Lucas-Luwa/steno-keyboard/V3/images/earlier-cover-fit-poster.jpg

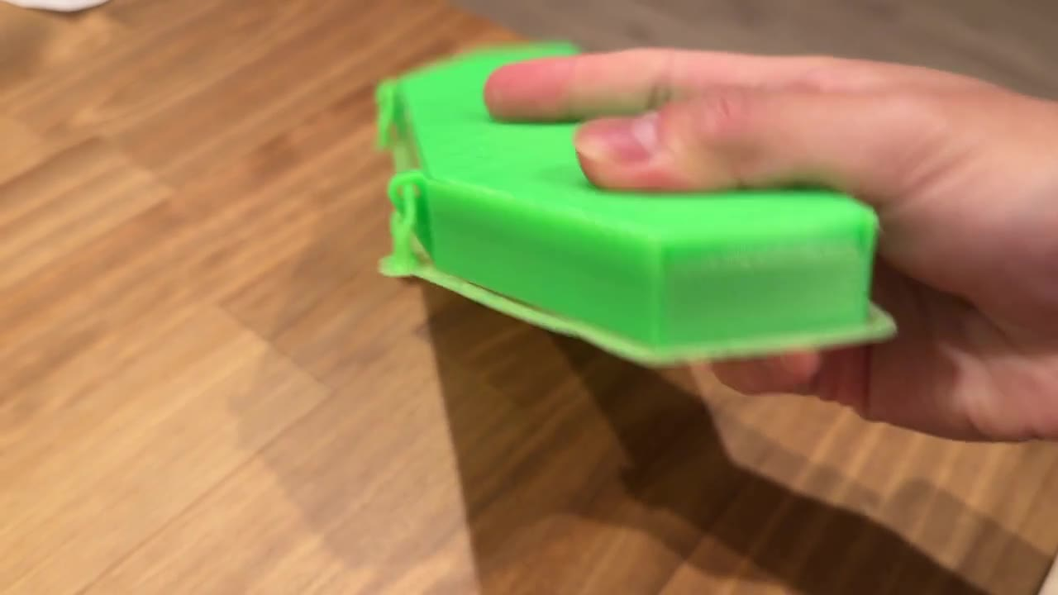
V3/images/earlier-cover-fit-poster.jpg
