Lucas-Luwa/steno-keyboard/V3/images/led-diagnostic-chase-poster.jpg

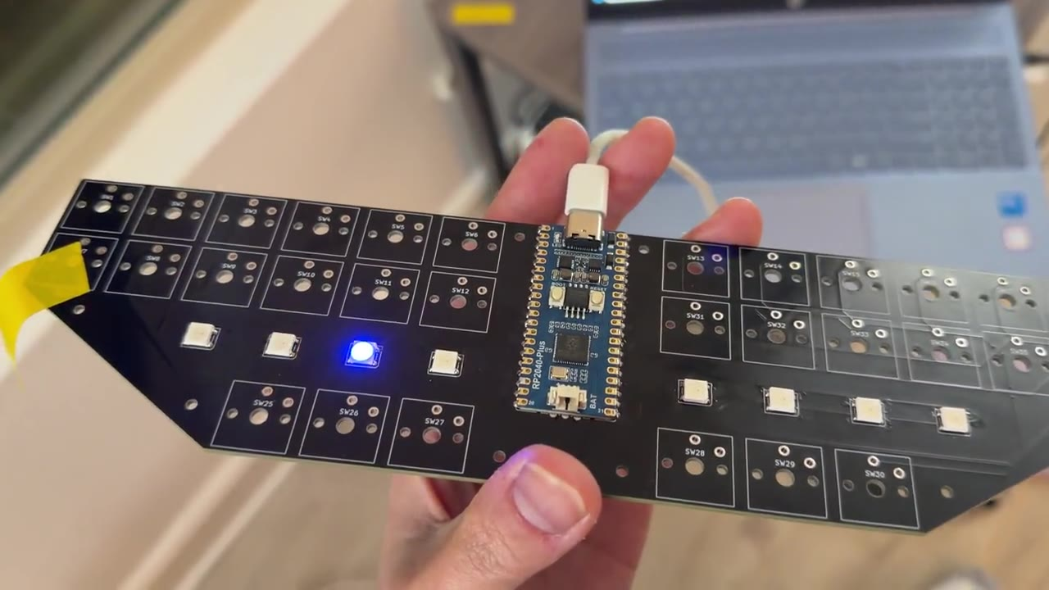
V3/images/led-diagnostic-chase-poster.jpg
