Lucas-Luwa/steno-keyboard/V3/images/lighting-idle-and-key-activity-poster.jpg

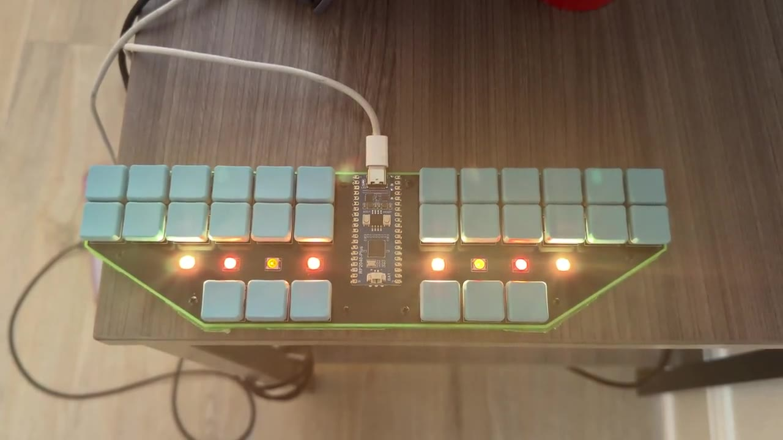
V3/images/lighting-idle-and-key-activity-poster.jpg
