Lucas-Luwa/steno-keyboard/V3/images/onboard-lighting-demo-poster.jpg

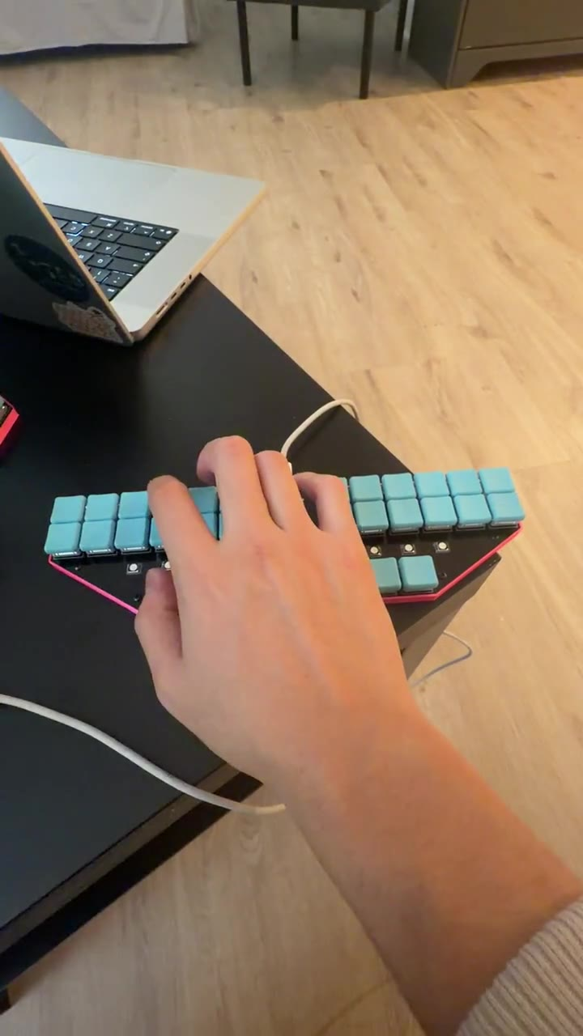
V3/images/onboard-lighting-demo-poster.jpg
