Lucas-Luwa/steno-keyboard/V3/images/pcb-back.png

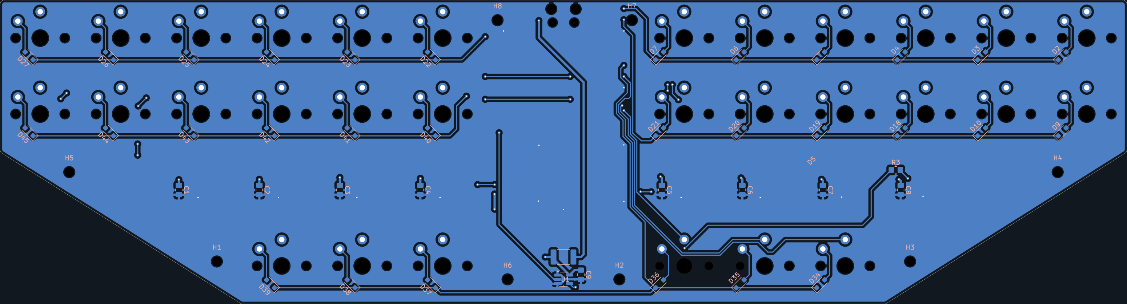
V3/images/pcb-back.png
