Lucas-Luwa/steno-keyboard/V3/hardware/bom.csv

quantity | references | value | footprint | notes
9 | C1 C2 C3 C4 C5 C6 C7 C8 C9 | 100n | Capacitor_SMD:C_0805_2012Metric_Pad1.18x1.45mm_HandSolder | 100 nF capacitor; 0805.
30 | D2 D3 D4 D5 D6 D7 D9 D10 D18 D19 D20 D21 D22 D23 D24 D25 D26 D27 D34 D35 D36 D37 D38 D39 D40 D41 D42 D43 D44 D45 | 1N4148W | Diode_SMD:D_SOD-323_HandSoldering | 1N4148-family diode in SOD-323 (e.g. 1N4148WS); band marks cathode.
1 | R3 | 330R | Resistor_SMD:R_0805_2012Metric_Pad1.20x1.40mm_HandSolder | 330 ohm LED data resistor; 0805.
1 | U1 | 74AHCT1G125 | Package_TO_SOT_SMD:SOT-23-5_HandSoldering | SOT-23-5 buffer; 74AHCT1G125 or SN74LV1T34DBVR. Pin connections: hardware guide.
1 | F1 | MF_MSMF050-2 | Fuse:Fuse_1812_4532Metric_Pad1.30x3.40mm_HandSolder | Resettable fuse; 1812.
8 | H1 H2 H3 H4 H5 H6 H7 H8 | MountingHole | MountingHole:MountingHole_2.2mm_M2 | 2.2 mm PCB clearance hole for M2 screw.
1 | A1 | RaspberryPi_Pico | Module:RaspberryPi_Pico_SMD_HandSolder | Waveshare RP2040-Plus-16MB; Pico-compatible castellated footprint.
30 | SW1 SW2 SW3 SW4 SW5 SW6 SW7 SW8 SW9 SW10 SW11 SW12 SW13 SW14 SW15 SW16 SW17 SW18 SW25 SW26 SW27 SW28 SW29 SW30 SW31 SW32 SW33 SW34 SW35 SW36 | SW_Push | Switch_Keyboard_Kailh:SW_Kailh_Choc_V1_1.00u | Kailh Choc V1 switch.
8 | LED8 LED12 LED13 LED14 LED15 LED16 LED17 LED28 | WS2812C | LED_SMD:LED_WS2812B_PLCC4_5.0x5.0mm_P3.2mm | WS2812B RGB LED; 5 x 5 mm four-pin footprint. WS2812C is the schematic value label.
