Lucas-Luwa/steno-keyboard/V3/mechanical/step/pcb-assembly.step

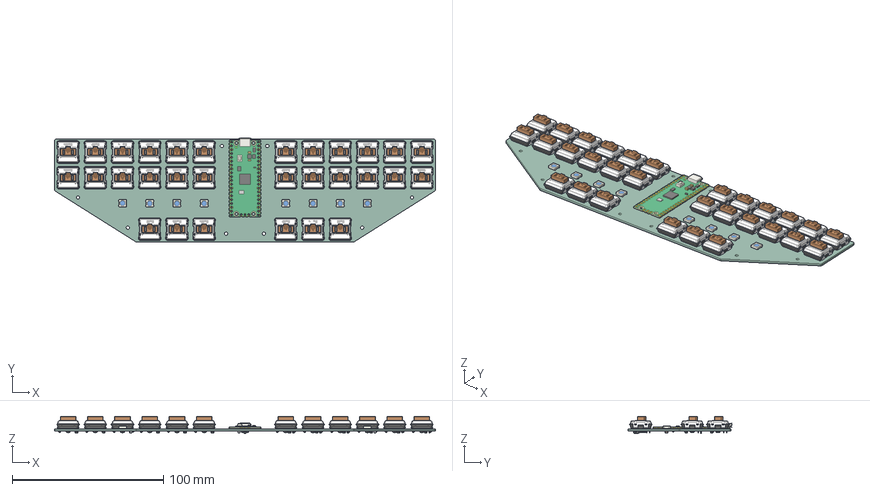
[picture p17: CAD file, 2026-10-21]
V3/mechanical/step/pcb-assembly.step
252.0 x 68.8 x 11.3 mm
LED_WS2812B_PLCC4_50x50mm_P32mm x 8
SW_Kailh_Choc_V1_cp x 30
RaspberryPi_Pico_Module_KiCad
terminals
C_0805_2012Metric x 9
D_SOD-323 x 30
SOT-23-5
R_0805_2012Metric
SteE9F_PCB
