Lucas-Luwa/steno-keyboard/V3/mechanical/solidworks/StenoFullASMV1SINGLEPART.SLDPRT

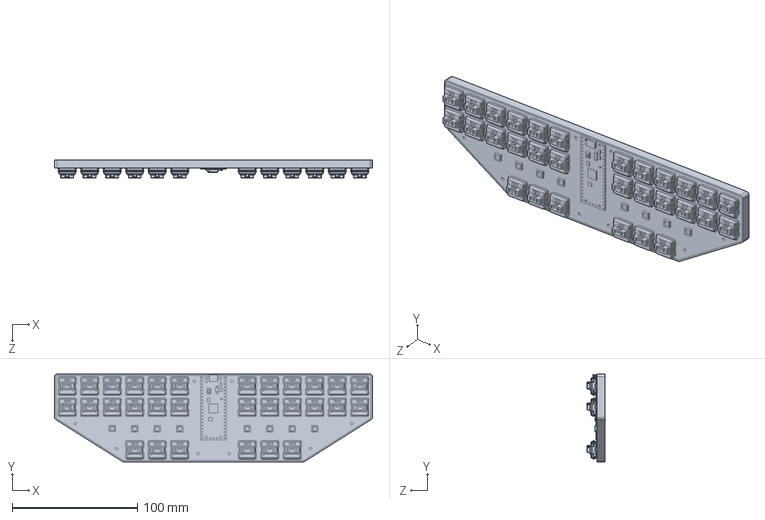
[picture p18: CAD file, 2026-10-21]
V3/mechanical/solidworks/StenoFullASMV1SINGLEPART.SLDPRT
254.3 x 70.3 x 14.3 mm
