Lucas-Luwa/steno-keyboard/V3/hardware/models/SW_Kailh_Choc_V1.stp

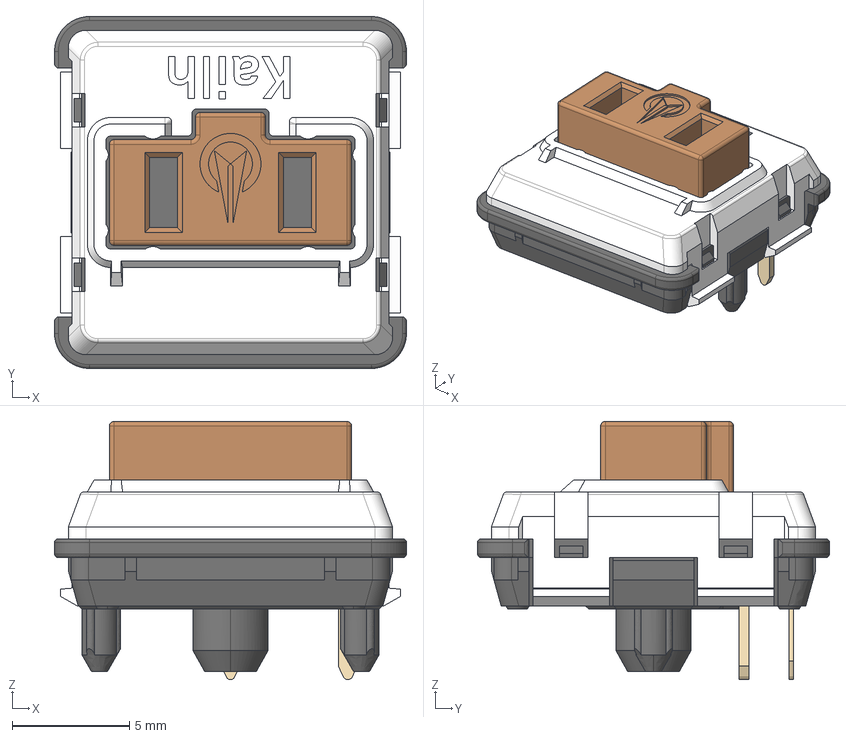
[picture p19: CAD file, 2026-10-21]
V3/hardware/models/SW_Kailh_Choc_V1.stp
15.0 x 15.0 x 11.0 mm
