Lucas-Luwa/steno-keyboard/V3/mechanical/step/travel-cap.step

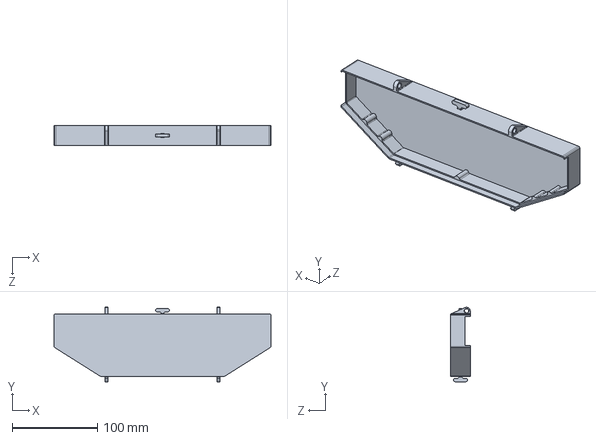
[picture p20: CAD file, 2026-10-28]
V3/mechanical/step/travel-cap.step
254.3 x 87.4 x 23.0 mm
