Lucas-Luwa/steno-keyboard/V3/mechanical/stl/case-bottom.stl

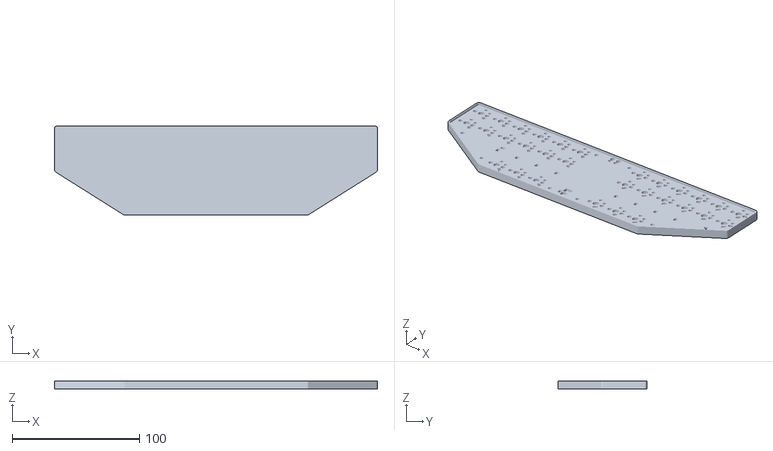
[picture p21: CAD file, 2026-10-21]
V3/mechanical/stl/case-bottom.stl
254.3 x 70.3 x 6.34
