Lucas-Luwa/steno-keyboard/V3/hardware/models/mf-msmf050-2.step

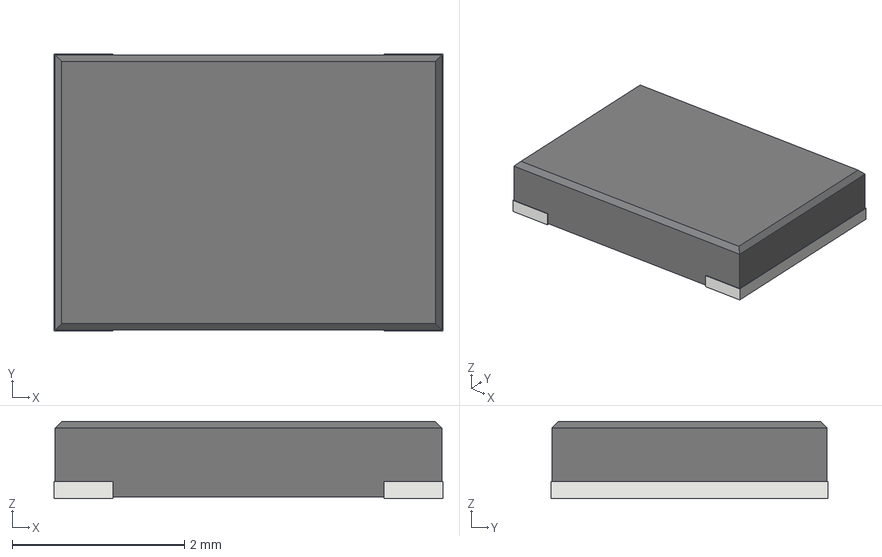
[picture p22: CAD file, 2026-10-13]
V3/hardware/models/mf-msmf050-2.step
4.52 x 3.22 x 0.9 mm
terminals
