Lucas-Luwa/steno-keyboard/V3/mechanical/solidworks/LEDAlignmentJigShort.SLDPRT

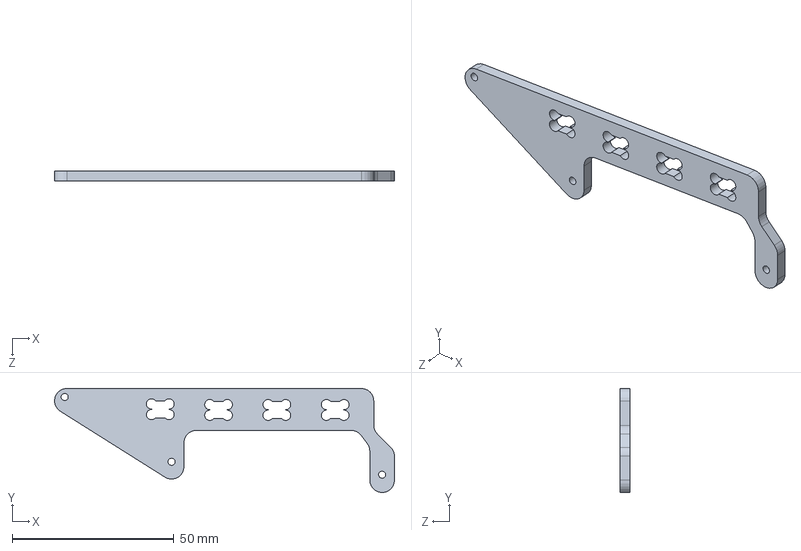
[picture p23: CAD file, 2026-10-26]
V3/mechanical/solidworks/LEDAlignmentJigShort.SLDPRT
105.0 x 32.1 x 3.17 mm
