Lucas-Luwa/steno-keyboard/V3/mechanical/stl/insert-test-coupon.stl

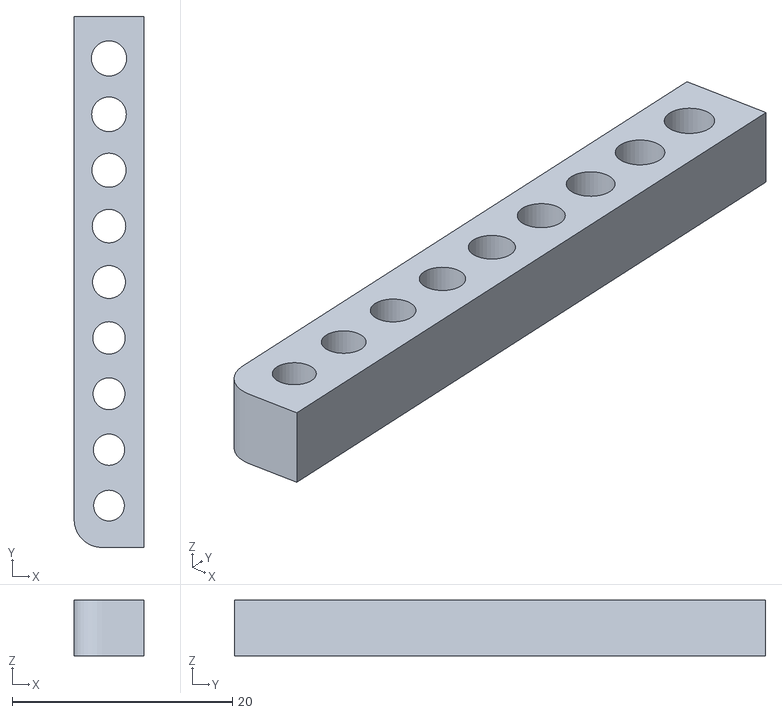
[picture p24: CAD file, 2026-10-21]
V3/mechanical/stl/insert-test-coupon.stl
6.35 x 48.3 x 5.08
