Lucas-Luwa/steno-keyboard/V3/mechanical/step/Choc_Stem_Choc_Size_Normal.step

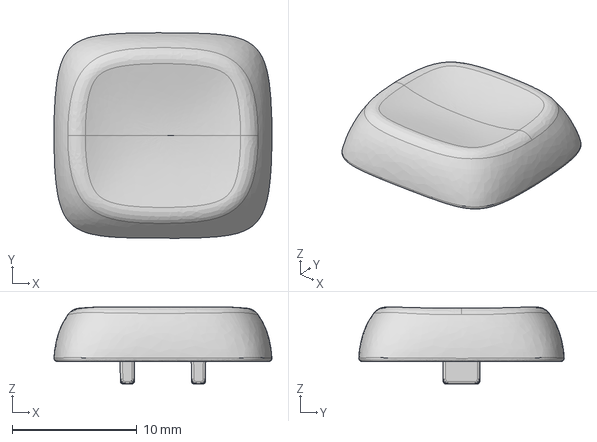
[picture p25: CAD file, 2026-10-21]
V3/mechanical/step/Choc_Stem_Choc_Size_Normal.step
17.5 x 16.5 x 6.17 mm
