Lucas-Luwa/steno-keyboard/V3/mechanical/solidworks/ChocKeyCap.SLDPRT

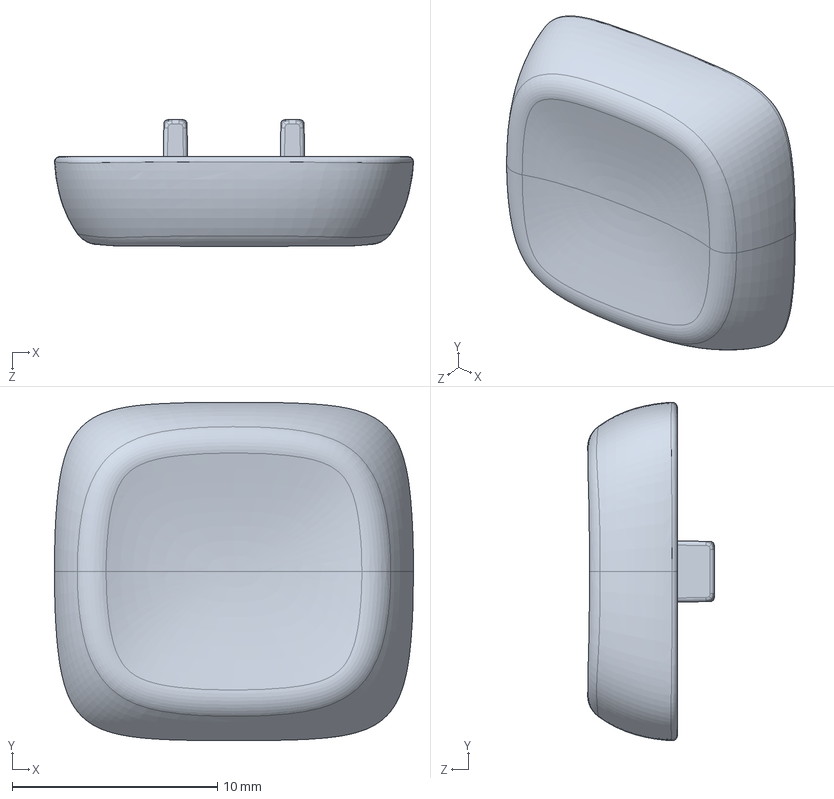
[picture p26: CAD file, 2026-10-21]
V3/mechanical/solidworks/ChocKeyCap.SLDPRT
17.5 x 16.5 x 6.17 mm
