Lucas-Luwa/steno-keyboard/V3/mechanical/solidworks/StenoFullASMV1.SLDASM

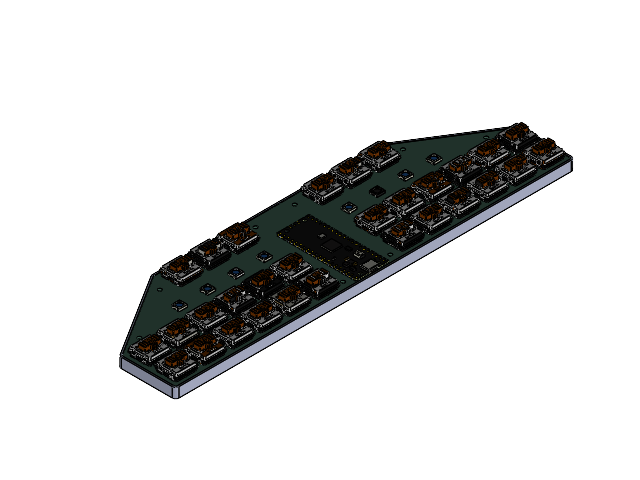
[picture p27: CAD file, 2026-10-21]
V3/mechanical/solidworks/StenoFullASMV1.SLDASM
BottomCasePARTONLYV1
StenoV5
