Lucas-Luwa/steno-keyboard/(list of files, cad)

Other CAD files:
V3/mechanical/solidworks/mf-msmf050-2_1.step.SLDASM
V3/mechanical/solidworks/LED_WS2812B_PLCC4_5.0x5.0mm_P3.2mm_1.step.SLDASM
V3/mechanical/solidworks/SW_Kailh_Choc_V1-1_1.step.SLDASM
V3/mechanical/solidworks/D_SOD-323_1.step.SLDASM
V3/mechanical/solidworks/C_0805_2012Metric_1.step.SLDASM
V3/mechanical/solidworks/SW_Kailh_Choc_V1_1.step.SLDASM
V3/mechanical/solidworks/Fuse_1812_4532Metric_1.step.SLDASM
V3/mechanical/solidworks/RaspberryPi_Pico_KiCad_1.step.SLDASM
V3/mechanical/solidworks/RaspberryPi_Pico_1.step.SLDASM
V3/mechanical/solidworks/SOT-23-5_1.step.SLDASM
V3/mechanical/solidworks/R_0805_2012Metric_1.step.SLDASM
V3/mechanical/print-jobs/A1/insert-test-coupon.gcode.3mf
V3/mechanical/print-jobs/P1S/insert-test-coupon.gcode.3mf
V3/mechanical/print-jobs/P2S/insert-test-coupon.gcode.3mf
V3/mechanical/solidworks/LEDAlignmentJig.SLDPRT
V3/mechanical/print-jobs/A1/travel-cap.gcode.3mf
V3/mechanical/print-jobs/P1S/case-bottom.gcode.3mf
V3/mechanical/print-jobs/P2S/travel-cap.gcode.3mf
V3/mechanical/print-jobs/A1/case-bottom.gcode.3mf
V3/mechanical/print-jobs/P1S/travel-cap.gcode.3mf
V3/mechanical/print-jobs/P2S/case-bottom.gcode.3mf
V3/mechanical/solidworks/BottomCasePARTONLYV1.SLDPRT
V3/mechanical/solidworks/body_1.step.SLDPRT
V3/mechanical/solidworks/StenoV5.SLDPRT
V3/mechanical/solidworks/TopCaseV3.SLDPRT
V3/mechanical/solidworks/SW_Kailh_Choc_V1_cp_1.step.SLDPRT
V3/mechanical/solidworks/R_0805_2012Metric-4_1.step.SLDPRT
V3/mechanical/solidworks/Ste5C4A_PCB_1.step.SLDPRT
V3/mechanical/solidworks/SOT-23-5-0_1.step.SLDPRT
V3/mechanical/solidworks/TestPrintHoles.SLDPRT
V3/mechanical/solidworks/terminals_1.step.SLDPRT
V3/mechanical/solidworks/LED_WS2812B_PLCC4_50x50mm_P32mm_1.step.SLDPRT
V3/mechanical/solidworks/C_0805_2012Metric-2_1.step.SLDPRT
V3/mechanical/solidworks/Bottom Prototype.SLDPRT
V3/mechanical/solidworks/SW_Kailh_Choc_V1_cp-1_1.step.SLDPRT
V3/mechanical/solidworks/RaspberryPi_Pico_Module_KiCad_1.step.SLDPRT
V3/mechanical/solidworks/D_SOD-323-3_1.step.SLDPRT
V3/mechanical/solidworks/TopCaseV1.SLDPRT
V3/mechanical/solidworks/TopCaseV2.SLDPRT
V3/mechanical/solidworks/travel-cap.SLDPRT
V3/mechanical/stl/led-alignment-jig-short.stl
V3/mechanical/stl/led-alignment-jig.stl
V3/mechanical/stl/travel-cap.stl
archive/prints/BottomCasePARTONLYV1.STL
archive/prints/BottomSTLV1.STL
archive/prints/BottomSTLV2.STL
archive/prints/travel-cap-previous-A1.gcode.3mf
archive/prints/travel-cap-previous-P1S.gcode.3mf
archive/prints/travel-cap-previous-P2S.gcode.3mf
archive/prints/travel-cap-previous.stl
