Lucas-Luwa/steno-keyboard/V3/firmware/led-tests/energy-catalog.md

# Fast/fade extension: 35 cues

Use the IDs with `run.py --pattern ID`; add `--energy` for extension cues.

| Section | ID | Description | Seconds |
| --- | --- | --- | ---: |
| energy | `energy-fade-slow` | Smooth fade in/out: zero to selected peak | 8 |
| energy | `energy-fade-fast` | Fast fade in/out: two pulses per second | 6 |
| energy | `energy-attack-decay` | Sharp attack with a fading tail | 6 |
| energy | `energy-crossfade` | Left and right crossfade | 6 |
| energy | `energy-colour-fade` | Rapid smooth saturated color fades | 6 |
| energy | `energy-out-12` | 4+5, 3+6, 2+7, 1+8: 12 pair steps/sec | 6 |
| energy | `energy-out-24` | 4+5, 3+6, 2+7, 1+8: 24 pair steps/sec | 6 |
| energy | `energy-out-40` | 4+5, 3+6, 2+7, 1+8: 40 pair steps/sec | 6 |
| energy | `energy-in` | Outside-in pairs: 24 steps/sec | 6 |
| energy | `energy-pingpong` | Center-out then edge-in: 24 steps/sec | 6 |
| energy | `energy-fill` | Pairs rapidly fill out from the center | 6 |
| energy | `energy-stripe-trails` | Center-out pairs with fading trails | 6 |
| energy | `energy-stripe-rainbow` | Center-out pairs cycle saturated hues | 6 |
| energy | `energy-stripe-random` | Center-out pairs change to a random color each sweep | 6 |
| energy | `energy-chase-16` | Fast chase: 16 LED positions/sec | 6 |
| energy | `energy-chase-32` | Fast chase: 32 LED positions/sec | 6 |
| energy | `energy-chase-64` | Fast chase: 64 LED positions/sec | 6 |
| energy | `energy-scanner` | Fast bouncing scanner: 40 positions/sec | 6 |
| energy | `energy-comets` | Opposing colored comets: 32 positions/sec | 6 |
| energy | `energy-opposed` | Opposing dots: 32 positions/sec | 6 |
| energy | `energy-colour-12` | Whole row switches random colors 12 times/sec | 6 |
| energy | `energy-colour-24` | Whole row switches random colors 24 times/sec | 6 |
| energy | `energy-random-pixels` | All pixels change independently 24 times/sec | 6 |
| energy | `energy-bursts` | Random colored spatial bursts 16 times/sec | 6 |
| energy | `energy-sparkles` | Rapid isolated colored sparks: 40 updates/sec | 6 |
| energy | `energy-alternate` | Rapid left/right color alternation | 6 |
| energy | `energy-180` | 180 BPM sixteenth-note motion | 6 |
| energy | `energy-220` | 220 BPM sixteenth-note motion | 6 |
| energy | `energy-triplets` | 200 BPM triplet motion | 6 |
| energy | `energy-build-drop` | Accelerating stripes, dark gap, then colored bursts | 8 |
| energy | `energy-strobe-8` | Magenta flashes: 8 Hz | 6 |
| energy | `energy-strobe-12` | Magenta flashes: 12 Hz | 6 |
| energy | `energy-strobe-16` | Magenta flashes: 16 Hz | 6 |
| energy | `energy-burst-strobe` | Random-color double/triple flash bursts | 6 |
| energy | `energy-mix` | Rapid pattern switching: stripes/chase/bursts/sparkles | 8 |
