Lucas-Luwa/steno-keyboard/V3/firmware/led-tests/catalogue.md

# Base showcase: 134 cues

Use the IDs with `run.py --pattern ID`; add `--energy` for extension cues.

| Section | ID | Description | Seconds |
| --- | --- | --- | ---: |
| mapping | `map-01` | Position 1: LED17 | 2 |
| mapping | `map-02` | Position 2: LED16 | 2 |
| mapping | `map-03` | Position 3: LED15 | 2 |
| mapping | `map-04` | Position 4: LED14 | 2 |
| mapping | `map-05` | Position 5: LED13 | 2 |
| mapping | `map-06` | Position 6: LED12 | 2 |
| mapping | `map-07` | Position 7: LED8 | 2 |
| mapping | `map-08` | Position 8: LED28 | 2 |
| mapping | `map-left` | Four left LEDs only | 3 |
| mapping | `map-right` | Four right LEDs only | 3 |
| colors | `color-red` | red | 3 |
| colors | `color-green` | green | 3 |
| colors | `color-blue` | blue | 3 |
| colors | `color-yellow` | yellow | 3 |
| colors | `color-cyan` | cyan | 3 |
| colors | `color-magenta` | magenta | 3 |
| colors | `color-orange` | orange | 3 |
| colors | `color-amber` | amber | 3 |
| colors | `color-lime` | lime | 3 |
| colors | `color-emerald` | emerald | 3 |
| colors | `color-teal` | teal | 3 |
| colors | `color-sky-blue` | sky blue | 3 |
| colors | `color-royal-blue` | royal blue | 3 |
| colors | `color-violet` | violet | 3 |
| colors | `color-purple` | purple | 3 |
| colors | `color-hot-pink` | hot pink | 3 |
| colors | `color-rose` | rose | 3 |
| colors | `color-coral` | coral | 3 |
| colors | `color-lavender` | lavender | 3 |
| colors | `color-pastel-pink` | pastel pink | 3 |
| colors | `color-ice-blue` | ice blue | 3 |
| colors | `color-warm-purple` | warm purple | 3 |
| brightness | `steps-red` | Raw brightness steps: red | 22.5 |
| brightness | `steps-green` | Raw brightness steps: green | 22.5 |
| brightness | `steps-blue` | Raw brightness steps: blue | 22.5 |
| brightness | `steps-magenta` | Raw brightness steps: magenta | 22.5 |
| brightness | `steps-cyan` | Raw brightness steps: cyan | 22.5 |
| brightness | `steps-orange` | Raw brightness steps: orange | 22.5 |
| brightness | `steps-lavender` | Raw brightness steps: lavender | 22.5 |
| brightness | `compare-16-32` | Magenta A/B: 16 versus 32 | 8 |
| brightness | `compare-16-64` | Magenta A/B: 16 versus 64 | 8 |
| brightness | `compare-16-128` | Magenta A/B: 16 versus 128 | 8 |
| brightness | `compare-16-255` | Magenta A/B: 16 versus 255 | 8 |
| brightness | `compare-64-128` | Magenta A/B: 64 versus 128 | 8 |
| brightness | `compare-128-255` | Magenta A/B: 128 versus 255 | 8 |
| brightness | `ramp-red` | Continuous raw ramp: red | 8 |
| brightness | `gamma-red` | Perceptual-style ramp: red | 8 |
| brightness | `ramp-magenta` | Continuous raw ramp: magenta | 8 |
| brightness | `gamma-magenta` | Perceptual-style ramp: magenta | 8 |
| brightness | `ramp-lavender` | Continuous raw ramp: lavender | 8 |
| brightness | `gamma-lavender` | Perceptual-style ramp: lavender | 8 |
| brightness | `density-one` | One LED versus eight at the same channel level | 8 |
| motion | `chase-red` | One red dot, left to right | 7 |
| motion | `chase-blue-back` | One blue dot, right to left | 7 |
| motion | `chase-rainbow` | One dot changes hue as it moves | 7 |
| motion | `chase-pair` | Two adjacent moving dots | 7 |
| motion | `chase-opposed` | Two dots move in opposite directions | 7 |
| motion | `bounce` | Single dot bounces at the ends | 7 |
| motion | `scanner` | Scanner with a soft trail | 7 |
| motion | `comet-short` | Short comet tail | 7 |
| motion | `comet-long` | Long comet tail | 7 |
| motion | `chase-fast` | Fast single-dot chase | 7 |
| motion | `chase-slow` | Slow single-dot chase | 7 |
| motion | `fill-drain` | Fill then drain the row | 8 |
| motion | `color-wipe` | Colour wipe across all eight | 8 |
| motion | `rainbow-conveyor` | Moving saturated rainbow | 8 |
| motion | `gradient-conveyor` | Moving purple/cyan gradient | 8 |
| motion | `sine-wave` | Smooth wave of brightness | 8 |
| motion | `two-waves` | Two overlapping coloured waves | 8 |
| motion | `bouncing-particle` | Smooth bouncing point with subpixel blending | 8 |
| motion | `random-walk` | A dot wanders between neighbours | 8 |
| motion | `binary` | Slow binary count in magenta | 8 |
| symmetry | `mirror-out` | Mirrored centre-to-edge dots | 8 |
| symmetry | `mirror-in` | Mirrored edge-to-centre dots | 8 |
| symmetry | `mirror-comet` | Mirrored centre-out comet trails | 8 |
| symmetry | `mirror-fill` | Both halves fill out from the centre | 8 |
| symmetry | `mirror-breathe` | Both halves breathe together | 8 |
| symmetry | `cross-breathe` | Left and right take turns breathing | 8 |
| symmetry | `alternate-banks` | Left/right colour alternation | 8 |
| symmetry | `split-colors` | Purple left / cyan right | 8 |
| symmetry | `checkerboard` | Alternating individual LEDs | 8 |
| symmetry | `paired-zones` | Four two-LED zones | 8 |
| symmetry | `centre-glow` | Centre glows with a soft falloff | 8 |
| symmetry | `edges-glow` | Outer edges glow with a soft falloff | 8 |
| textures | `breathe-purple` | Slow purple breathing | 10 |
| textures | `breathe-blue` | Slow blue breathing | 10 |
| textures | `hue-fade` | All LEDs fade through saturated hues | 10 |
| textures | `palette-neon` | Neon palette transitions | 10 |
| textures | `palette-ocean` | Ocean palette transitions | 10 |
| textures | `fire` | Warm flickering embers | 10 |
| textures | `ocean-shimmer` | Blue/teal shimmer | 10 |
| textures | `aurora` | Slow purple/green aurora | 10 |
| textures | `sparkle-sparse` | Sparse coloured sparkles | 10 |
| textures | `sparkle-dense` | Dense coloured sparkles | 10 |
| textures | `twinkle` | Soft independent twinkles | 10 |
| textures | `raindrops` | Drops appear and fade away | 10 |
| textures | `random-colors` | Random saturated colour per LED | 10 |
| textures | `noise-flow` | Flowing multicolour texture | 10 |
| beats | `beat-pulse-60` | Synthetic beat pulse: 60 BPM | 8 |
| beats | `beat-pulse-90` | Synthetic beat pulse: 90 BPM | 8 |
| beats | `beat-pulse-120` | Synthetic beat pulse: 120 BPM | 8 |
| beats | `beat-pulse-150` | Synthetic beat pulse: 150 BPM | 8 |
| beats | `beat-pulse-180` | Synthetic beat pulse: 180 BPM | 8 |
| beats | `beat-alternate` | Alternate halves on each beat | 12 |
| beats | `beat-color` | Choose a saturated colour on each beat | 12 |
| beats | `beat-step` | Advance one LED per beat | 12 |
| beats | `beat-mirror` | Launch a mirrored wave on each beat | 12 |
| beats | `beat-burst` | Random spatial burst on each beat | 12 |
| beats | `beat-kick` | Bass/kick: strong pulse with decay | 12 |
| beats | `beat-snare` | Snare/backbeat: alternate accented beats | 12 |
| beats | `beat-hats` | Hi-hat-style eighth-note sparkles | 12 |
| beats | `beat-layered` | Synthetic kick, snare and hats together | 12 |
| beats | `beat-subdivide` | Quarter/eighth/sixteenth-note motion | 12 |
| beats | `beat-half-double` | Half-time then double-time feel | 12 |
| beats | `beat-swing` | Swinging pairs of light pulses | 12 |
| beats | `beat-tempo-change` | Tempo ramps from 75 to 165 BPM | 12 |
| beats | `beat-build-drop` | Build, brief gap, then a drop | 12 |
| beats | `beat-silence` | Activity, silence with decay, activity | 12 |
| beats | `beat-pattern-picker` | Synthetic events choose different patterns | 12 |
| beats | `beat-features` | Synthetic bass/mid/treble independently shape the LEDs | 12 |
| detail | `detail-chase` | Four zones versus eight pixels: chase | 12 |
| detail | `detail-comet` | Four zones versus eight pixels: comet | 12 |
| detail | `detail-wave` | Four zones versus eight pixels: wave | 12 |
| detail | `detail-sparkle` | Four zones versus eight pixels: sparkle | 12 |
| flashes | `flash-1hz` | Labelled magenta flashes: 1 Hz | 5 |
| flashes | `flash-2hz` | Labelled magenta flashes: 2 Hz | 5 |
| flashes | `flash-4hz` | Labelled magenta flashes: 4 Hz | 5 |
| flashes | `flash-8hz` | Labelled magenta flashes: 8 Hz | 5 |
| flashes | `flash-12hz` | Labelled magenta flashes: 12 Hz | 5 |
| flashes | `flash-16hz` | Labelled magenta flashes: 16 Hz | 5 |
| flashes | `flash-alternating` | Alternating banks, four changes/second | 6 |
| flashes | `flash-double` | Double flash per synthetic beat | 6 |
| flashes | `flash-triplet` | Three-flash burst per synthetic beat | 6 |
| flashes | `flash-random` | Irregular magenta bursts | 6 |
