Lucas-Luwa/steno-keyboard/V3/hardware/StenoV3.kicad_pcb

## KiCad design V3/hardware/StenoV3.kicad_pcb (2026-10-21)

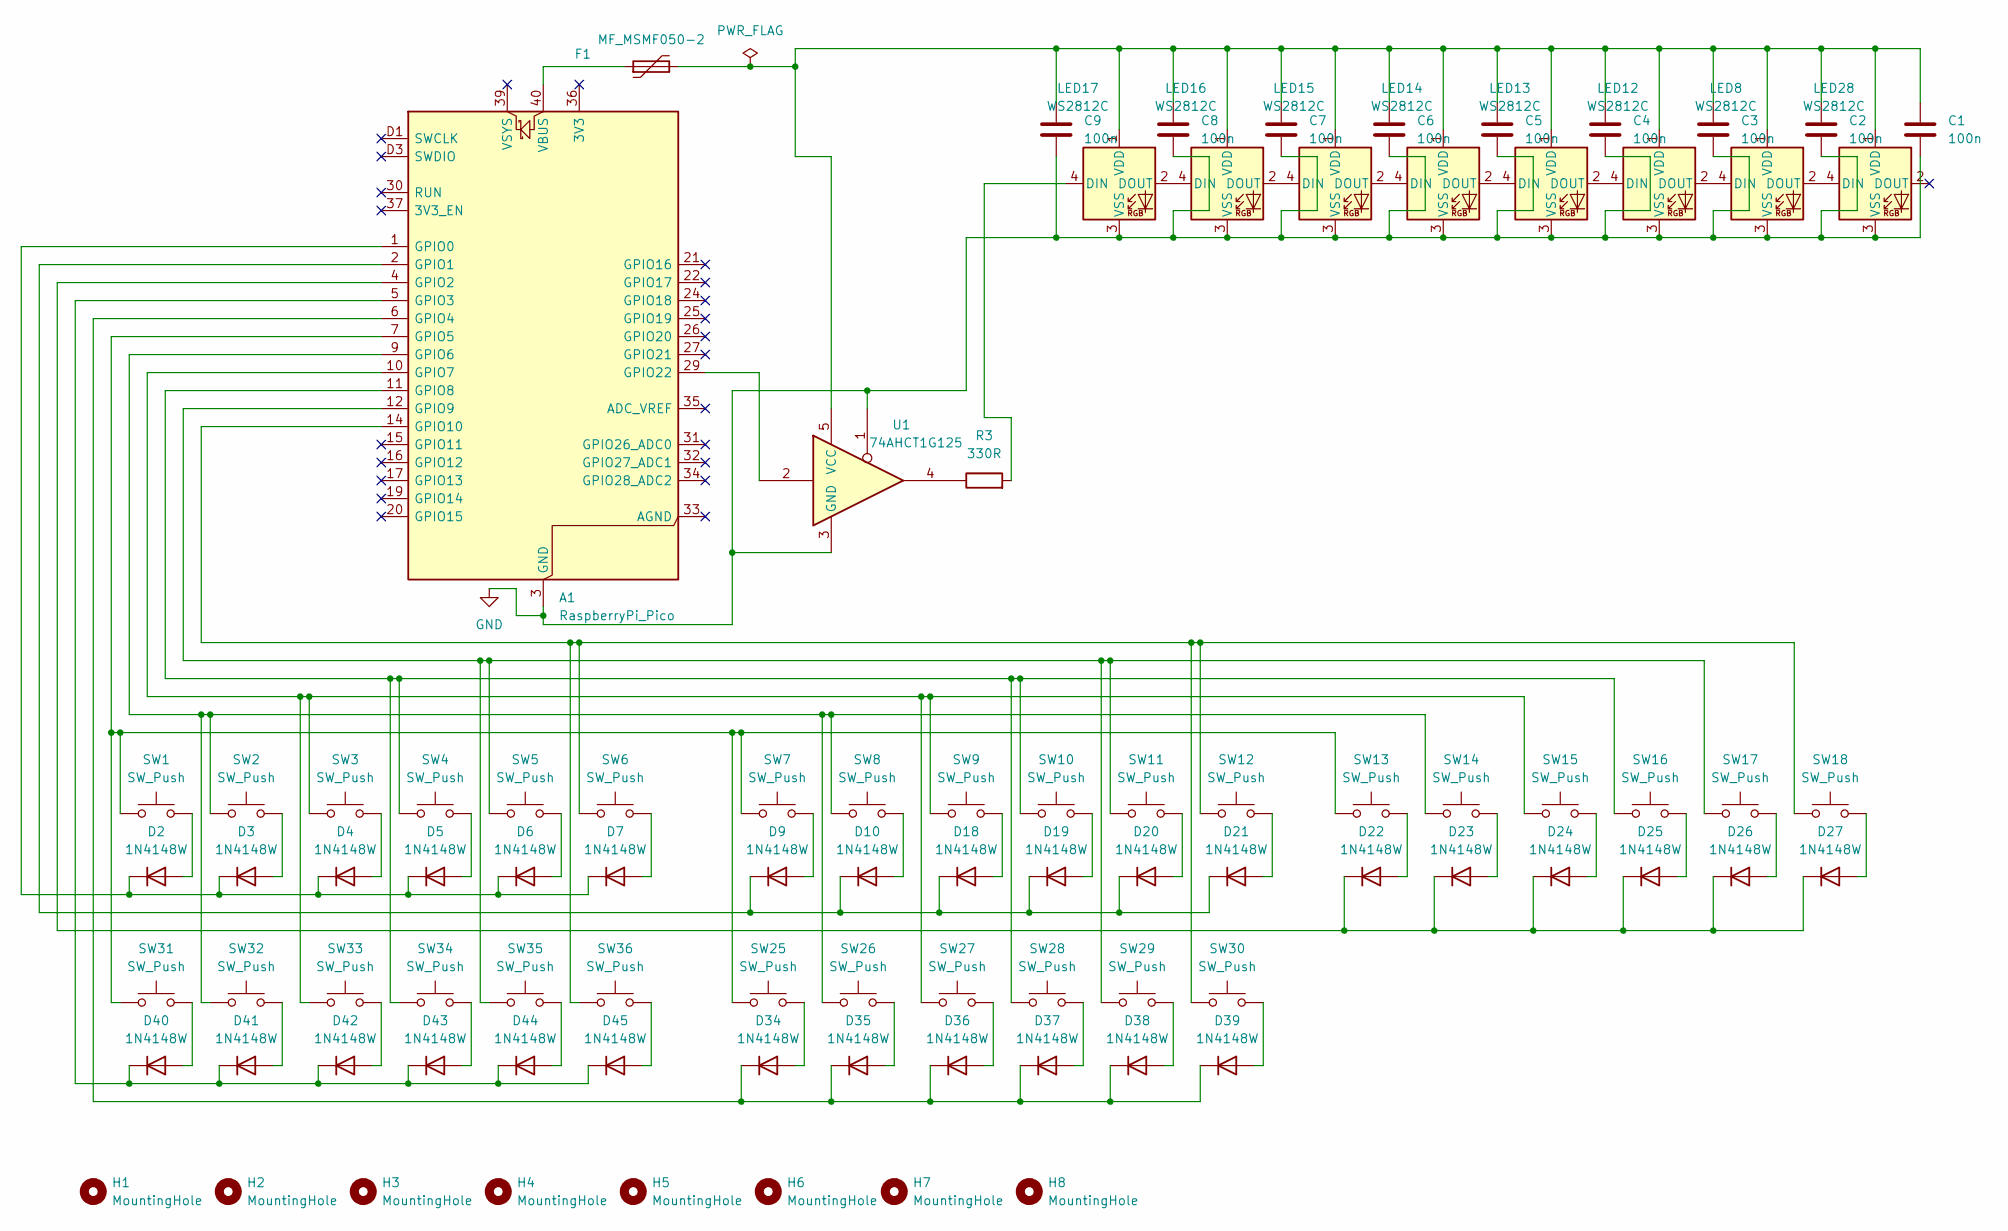
[picture p35: schematic StenoV3.kicad_sch]

Parts:
A1: RaspberryPi_Pico; RaspberryPi_Pico_SMD_HandSolder
C1, C2, C3, C4, C5, C6, C7, C8, C9: 100n; C_0805_2012Metric_Pad1.18x1.45mm_HandSolder
D2, D3, D4, D5, D6, D7, D9, D10, D18, D19, D20, D21, D22, D23, D24, D25, D26, D27, D34, D35, D36, D37, D38, D39, D40, D41, D42, D43, D44, D45: 1N4148W; D_SOD-323_HandSoldering
F1: MF_MSMF050-2; Fuse_1812_4532Metric_Pad1.30x3.40mm_HandSolder
H1, H2, H3, H4, H5, H6, H7, H8: MountingHole; MountingHole_2.2mm_M2
LED8, LED12, LED13, LED14, LED15, LED16, LED17, LED28: WS2812C; LED_WS2812B_PLCC4_5.0x5.0mm_P3.2mm
R3: 330R; R_0805_2012Metric_Pad1.20x1.40mm_HandSolder
SW1, SW2, SW3, SW4, SW5, SW6, SW7, SW8, SW9, SW10, SW11, SW12, SW13, SW14, SW15, SW16, SW17, SW18, SW25, SW26, SW27, SW28, SW29, SW30, SW31, SW32, SW33, SW34, SW35, SW36: SW_Push; SW_Kailh_Choc_V1_1.00u
U1: 74AHCT1G125; SOT-23-5_HandSoldering

Connections:
GND: A1.3 (GND), A1.8 (GND), A1.13 (GND), A1.18 (GND), A1.23 (GND), A1.28 (GND), A1.38 (GND), A1.D2 (GND), C1.2, C2.2, C3.2, C4.2, C5.2, C6.2, C7.2, C8.2, C9.2, LED8.3 (VSS), LED12.3 (VSS), LED13.3 (VSS), LED14.3 (VSS), LED15.3 (VSS), LED16.3 (VSS), LED17.3 (VSS), LED28.3 (VSS), U1.1, U1.3 (GND)
unnamed: A1.1 (GPIO0), D2.1 (K), D3.1 (K), D4.1 (K), D5.1 (K), D6.1 (K), D7.1 (K)
unnamed: A1.2 (GPIO1), D9.1 (K), D10.1 (K), D18.1 (K), D19.1 (K), D20.1 (K), D21.1 (K)
unnamed: A1.4 (GPIO2), D22.1 (K), D23.1 (K), D24.1 (K), D25.1 (K), D26.1 (K), D27.1 (K)
unnamed: A1.5 (GPIO3), D40.1 (K), D41.1 (K), D42.1 (K), D43.1 (K), D44.1 (K), D45.1 (K)
unnamed: A1.6 (GPIO4), D34.1 (K), D35.1 (K), D36.1 (K), D37.1 (K), D38.1 (K), D39.1 (K)
unnamed: A1.7 (GPIO5), SW1.1, SW7.1, SW13.1, SW25.1, SW31.1
unnamed: A1.9 (GPIO6), SW2.1, SW8.1, SW14.1, SW26.1, SW32.1
unnamed: A1.10 (GPIO7), SW3.1, SW9.1, SW15.1, SW27.1, SW33.1
unnamed: A1.11 (GPIO8), SW4.1, SW10.1, SW16.1, SW28.1, SW34.1
unnamed: A1.12 (GPIO9), SW5.1, SW11.1, SW17.1, SW29.1, SW35.1
unnamed: A1.14 (GPIO10), SW6.1, SW12.1, SW18.1, SW30.1, SW36.1
unnamed: A1.29 (GPIO22), U1.2
unnamed: A1.40 (VBUS), F1.1
unnamed: D2.2 (A), SW1.2
unnamed: D3.2 (A), SW2.2
unnamed: D4.2 (A), SW3.2
unnamed: D5.2 (A), SW4.2
unnamed: D6.2 (A), SW5.2
unnamed: D7.2 (A), SW6.2
unnamed: D9.2 (A), SW7.2
unnamed: D10.2 (A), SW8.2
unnamed: D18.2 (A), SW9.2
unnamed: D19.2 (A), SW10.2
unnamed: D20.2 (A), SW11.2
unnamed: D21.2 (A), SW12.2
unnamed: D22.2 (A), SW13.2
unnamed: D23.2 (A), SW14.2
unnamed: D24.2 (A), SW15.2
unnamed: D25.2 (A), SW16.2
unnamed: D26.2 (A), SW17.2
unnamed: D27.2 (A), SW18.2
unnamed: D34.2 (A), SW25.2
unnamed: D35.2 (A), SW26.2
unnamed: D36.2 (A), SW27.2
unnamed: D37.2 (A), SW28.2
unnamed: D38.2 (A), SW29.2
unnamed: D39.2 (A), SW30.2
unnamed: D40.2 (A), SW31.2
unnamed: D41.2 (A), SW32.2
unnamed: D42.2 (A), SW33.2
unnamed: D43.2 (A), SW34.2
unnamed: D44.2 (A), SW35.2
unnamed: D45.2 (A), SW36.2
unnamed: LED12.4 (DIN), LED13.2 (DOUT)
unnamed: LED8.4 (DIN), LED12.2 (DOUT)
unnamed: C1.1, C2.1, C3.1, C4.1, C5.1, C6.1, C7.1, C8.1, C9.1, F1.2, LED8.1 (VDD), LED12.1 (VDD), LED13.1 (VDD), LED14.1 (VDD), LED15.1 (VDD), LED16.1 (VDD), LED17.1 (VDD), LED28.1 (VDD), U1.5 (VCC)
unnamed: LED13.4 (DIN), LED14.2 (DOUT)
unnamed: LED14.4 (DIN), LED15.2 (DOUT)
unnamed: LED15.4 (DIN), LED16.2 (DOUT)
unnamed: LED16.4 (DIN), LED17.2 (DOUT)
unnamed: LED17.4 (DIN), R3.2
unnamed: LED8.2 (DOUT), LED28.4 (DIN)
unnamed: R3.1, U1.4

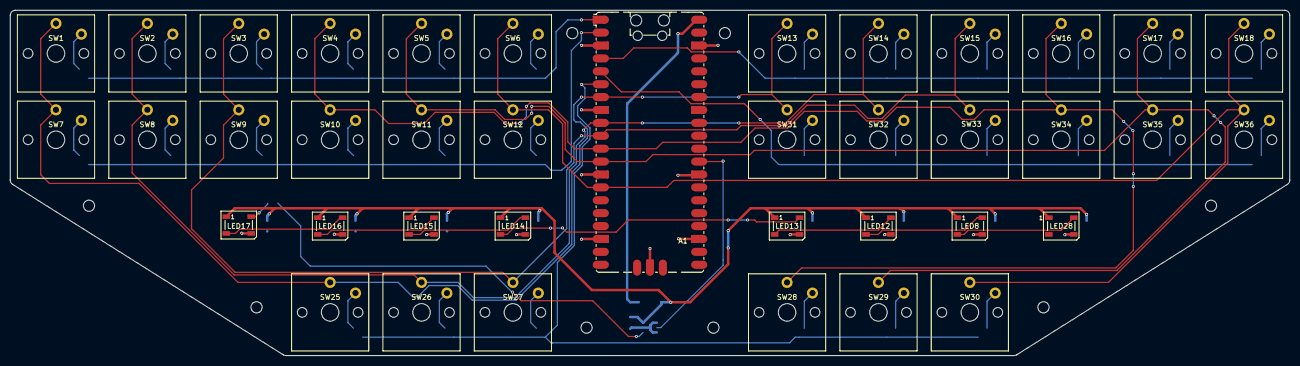
[picture p36: board StenoV3.kicad_pcb from above]

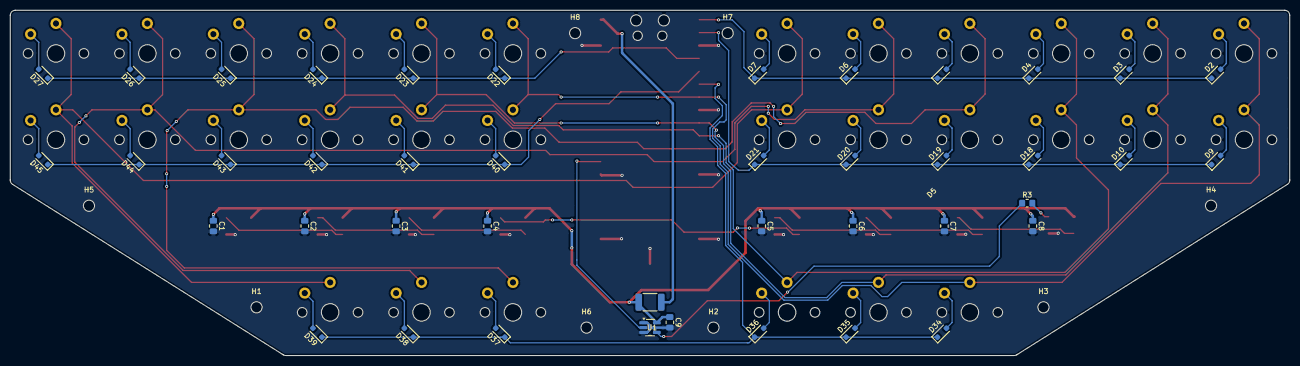
[picture p37: board StenoV3.kicad_pcb from below]

Board: 2 copper layers, 252.0 x 68.0 mm, 89 parts (42 on the bottom side), 54 nets.
