Lucas-Luwa/steno-keyboard/(commit log)

2026-10-13 V1 and V2
    [StenoV1.kicad_pcb, StenoV1.kicad_sch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]
2026-10-21 Initial Commit
    All Files
    [Bottom Prototype.SLDPRT, BottomCasePARTONLYV1.SLDPRT, BottomCasePARTONLYV1.STL, BottomSTLV1.STL, BottomSTLV2.STL, C_0805_2012Metric-2_1.step.SLDPRT, C_0805_2012Metric_1.step.SLDASM, ChocKeyCap.SLDPRT]
2026-10-26 Firmware and Additional Mechanical
    [LEDAlignmentJig.SLDPRT, LEDAlignmentJigShort.SLDPRT, key-matrix.csv, led-alignment-jig-short.stl, led-alignment-jig.stl]
2026-10-28 Lights Firmware + Top Cover Update
    [travel-cap-previous-A1.gcode.3mf, travel-cap-previous-P1S.gcode.3mf, travel-cap-previous-P2S.gcode.3mf, travel-cap-previous.stl, travel-cap.SLDPRT, travel-cap.step, travel-cap.stl]
2026-10-30 Documentation Update
    [StenoV1.kicad_pcb, StenoV2.kicad_pcb]
