Lucas-Luwa/steno-keyboard/V3/images/travel-cap-interior.jpg

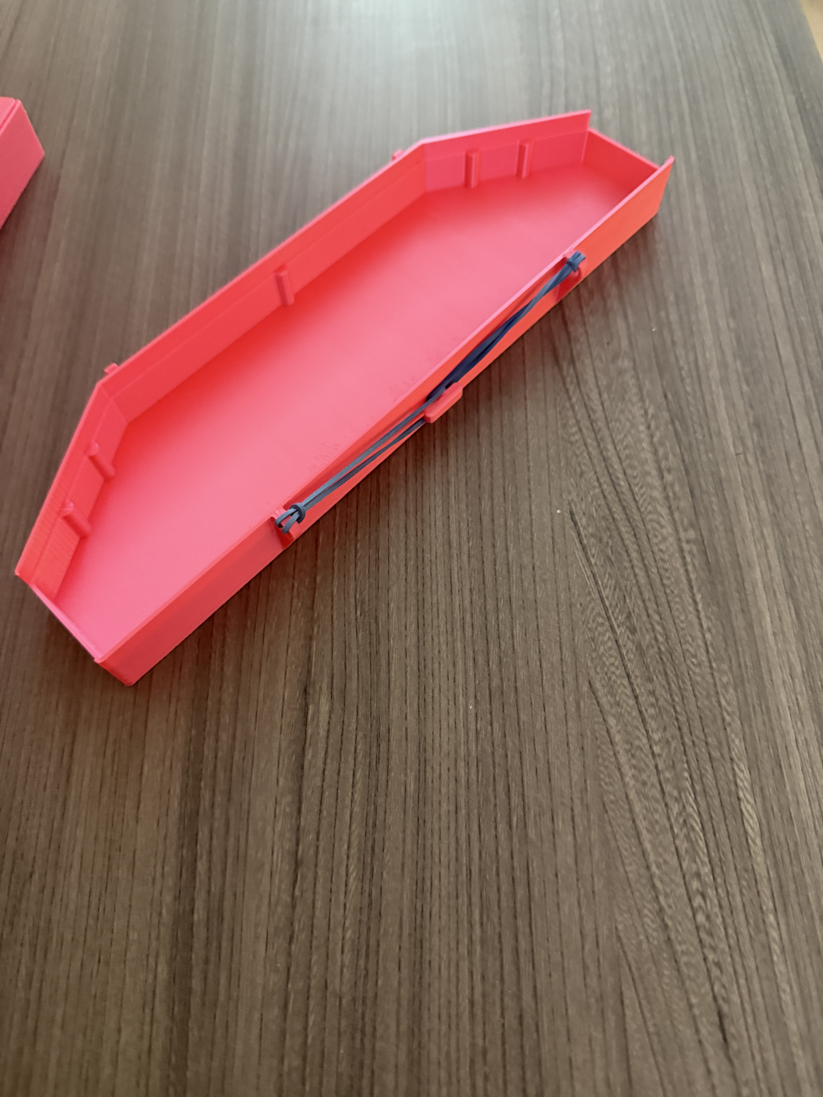
[picture p3: V3/images/travel-cap-interior.jpg]
V3/images/travel-cap-interior.jpg
