Lucas-Luwa/steno-keyboard/V3/images/travel-cap-cable-storage.jpg

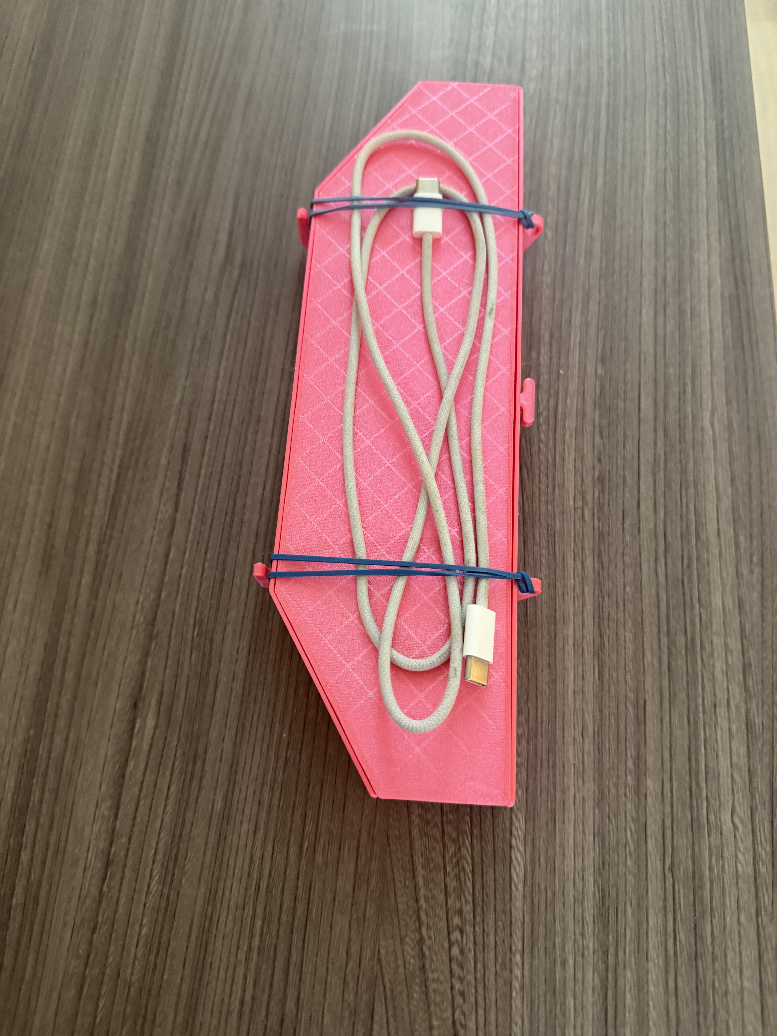
[picture p4: V3/images/travel-cap-cable-storage.jpg]
V3/images/travel-cap-cable-storage.jpg
