Lucas-Luwa/steno-keyboard/V3/images/travel-cap-secured.jpg

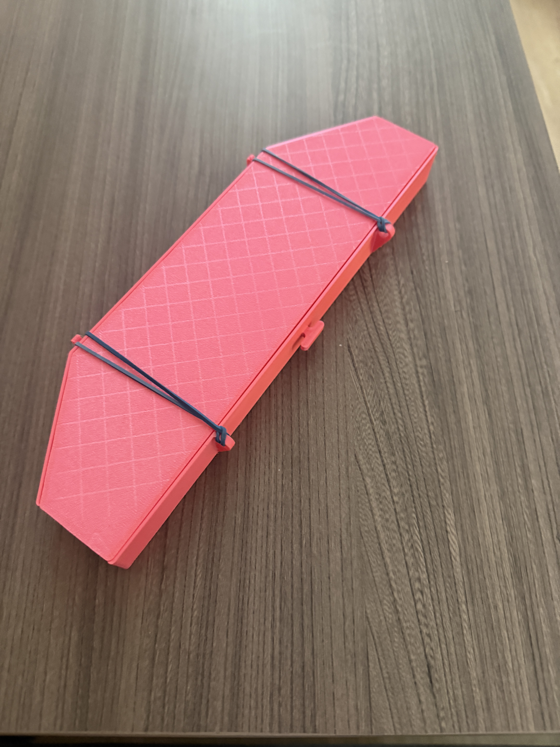
[picture p33: V3/images/travel-cap-secured.jpg]
V3/images/travel-cap-secured.jpg
